flisadam/RFID_system/README.md

# RFID_system
This is simple RFID system for behaviour experiments with caged animals. The efuipment developed within this project is part of EcoHab cage.
More information about this cage is published here: https://elifesciences.org/articles/19532
