flisadam/RFID_system/Master.pdf

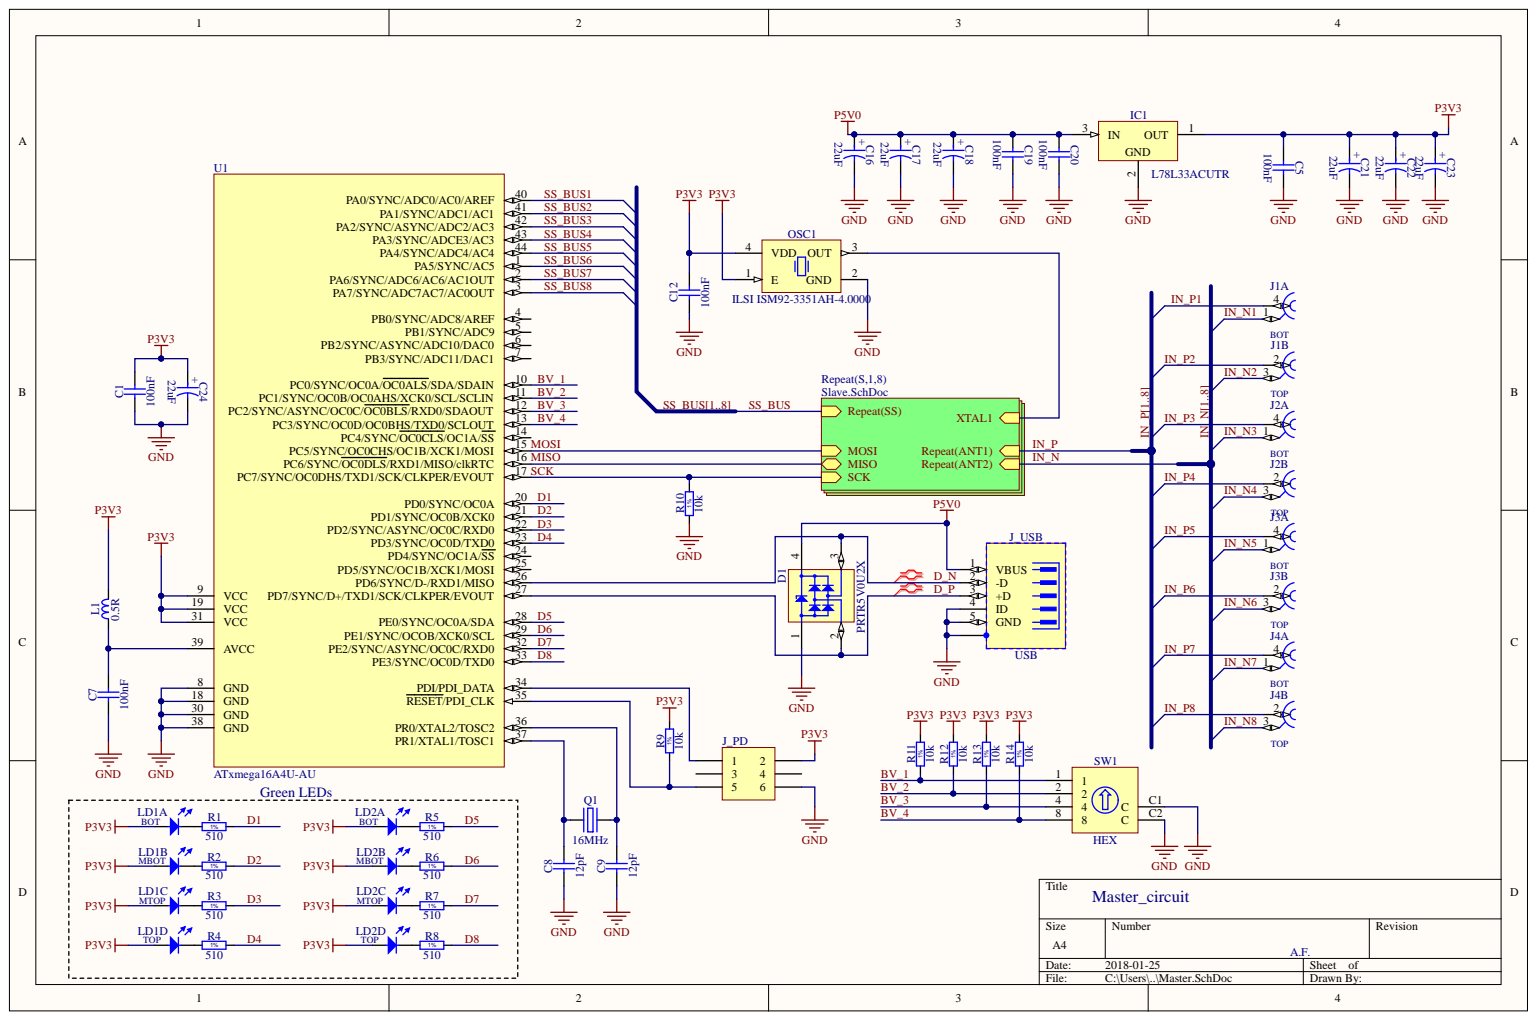
[picture p1: page 1]

GND 18 | P3V3

GND 38

# Board S
