flisadam/RFID_system/RFID_PCB.pdf

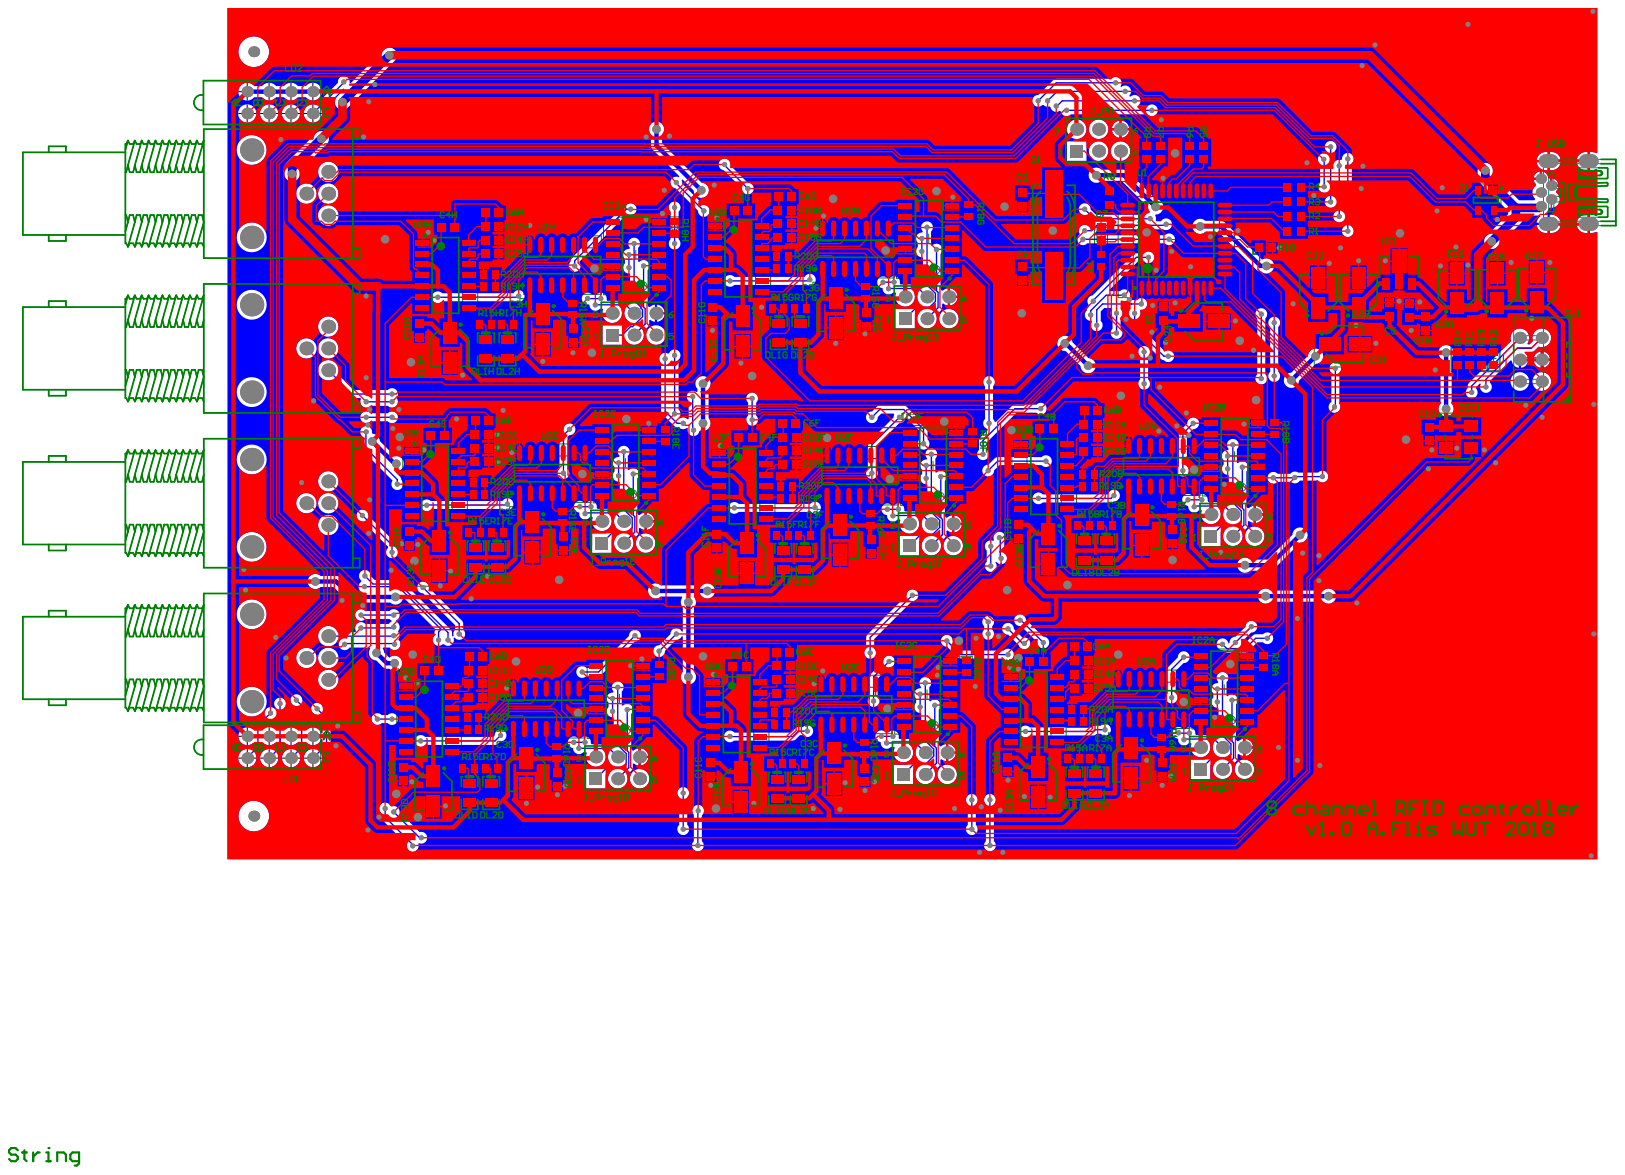
[picture p2: page 1]
