flisadam/RFID_system/Slave.pdf

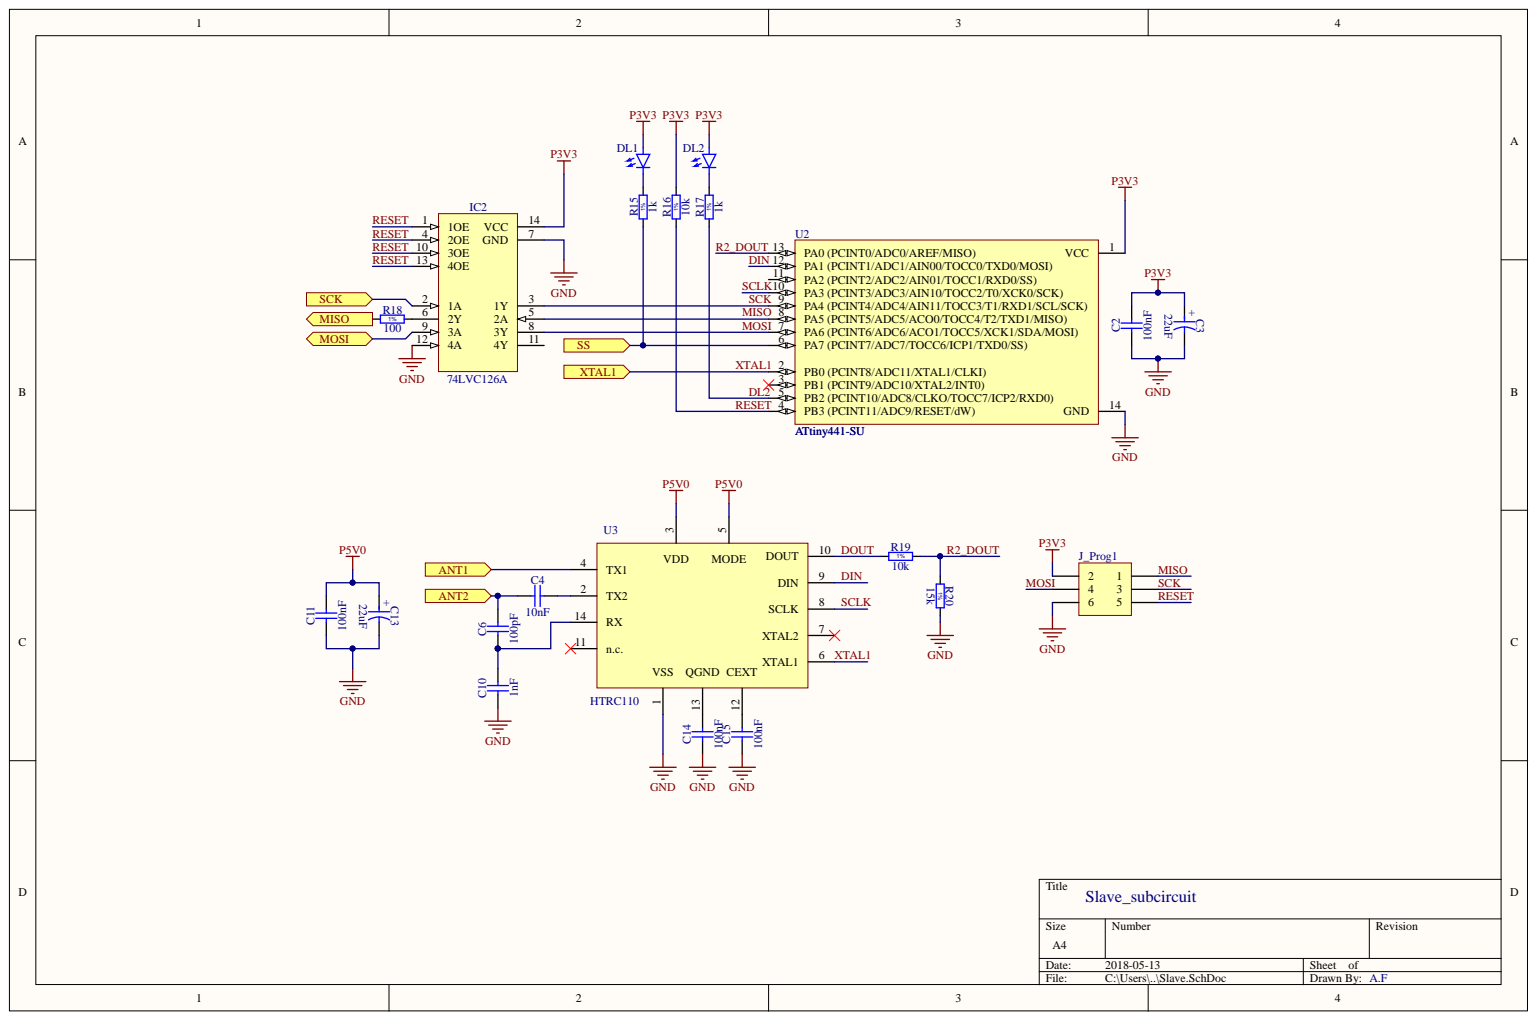
[picture p3: page 1]
