flisadam/RFID_system/Slave2.pdf

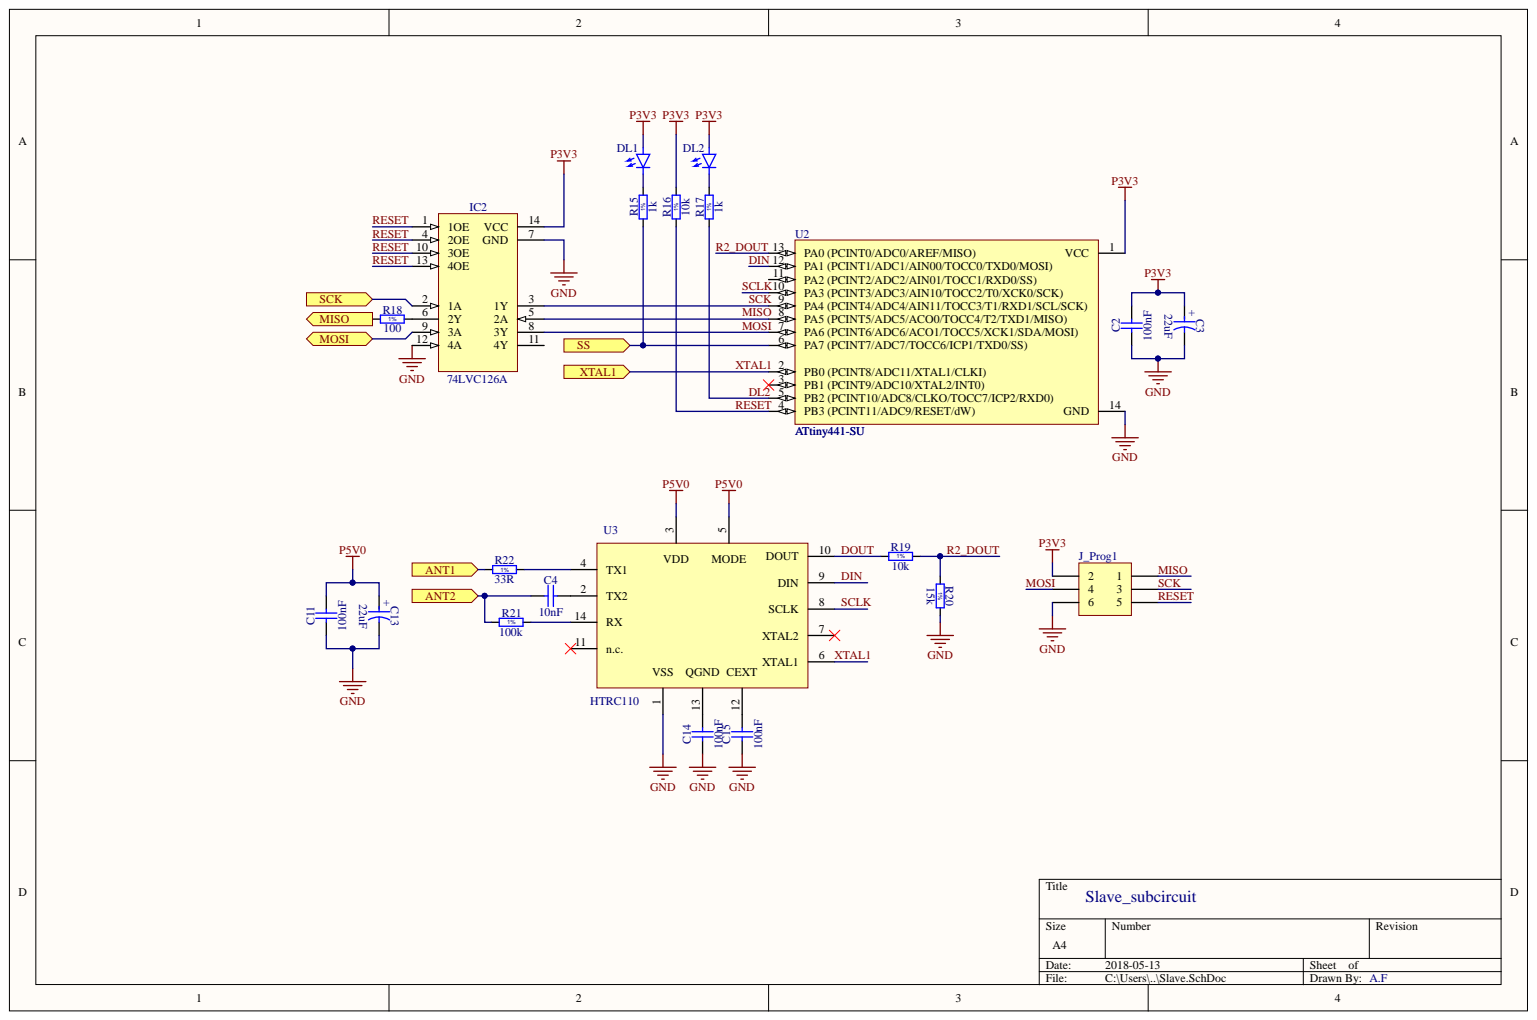
[picture p4: page 1]
