flisadam/RFID_system/Slave_new.pdf

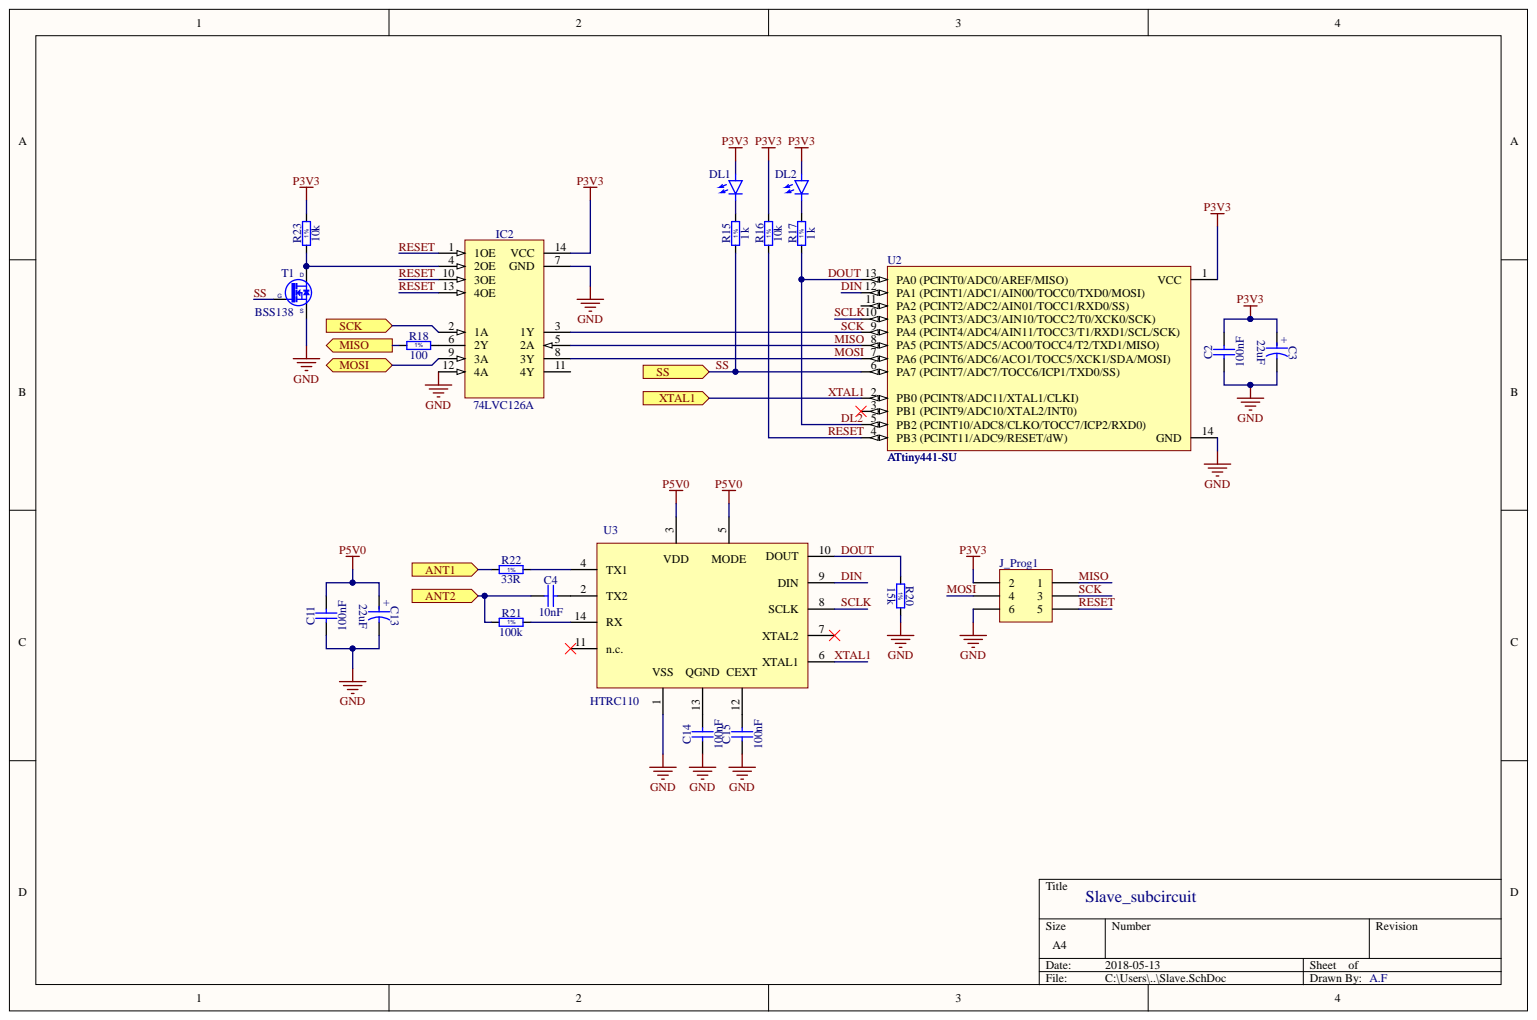
[picture p5: page 1]
