flisadam/RFID_system/(list of files, drawings)

Other design files:
Master.SchDoc
RFID_PCB.PcbDoc
RFID_system.PrjPcb
Slave.SchDoc
