flisadam/RFID_system/(threads)

Thread 2 (2017-11-21):

schematic review

gkasprow, 2017-11-21:
- [x] please remove all project -specific libraries. Install them as global. Now when I open the project it complains about missing libs.
- [x] add differential pair directive Place->Directie -> diff pairs
- [x] what is the role of P1 connector? Why there is same designator for both connectors?
- [x] don't use regular L with ceramic capacitor as filter. Use ferrite bead instead, otherwise it will oscillate.
- [x] fix this
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
- [x] there is serious error in USB connector grounding. Check it with application note. TVS GND should go to circuit GND!
- [x] RFID receivers must be synchronized together to not interfere with other channels. All RFID coils must have the same phase and frequency. Individual crystals don't provide such functionality.
- [x] SS line is not connected to the sheet entry

flisadam, 2017-11-22:
1.  I removed libraries. It should not complains now.
2. I added diff pair to USB D+ D- data.
3. I intented to use P1 as a switch on-off each CPU-slave and master with jumpers.
5.  I changed it. Hope it is more readable now.
6. I took connection of TVS to USB from that manual :
Atmel AVR1017: XMEGA - USB Hardware
Design Recommendations page 8
http://www.atmel.com/images/doc8388.pdf
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

7. Still to do.
8. I get a little bit confused about this. When i compile only Master.SchDoc- the message window returns error's of only one pin's connection
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
On the other hand when I compile hole project- there are none errors-just warnings about multiply name nets:
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
Finally when i check connection on the pcb everythink looks fine- I can connect with autoRoute each Slave SS pin in SS_bus with Xmega pins and also antenna bus
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

gkasprow, 2017-11-22:
6. Such USB TVS protection makes sense if you have metal enclosure with metallic panel that is connected with PE terminal. In such cases the ESD current flows to the chassis. We supply it from USB so these components are not needed and GND can be shorted with USB connector.
8. OK, it is fine, in my case for some reason Alt+click does not work.

In case of synchronization, you'd better visit biologists lab and see how it is done on prototype. It simply works and I don't remember how I did it :)

flisadam, 2017-11-23:
I changed the TVS connection-USB shield is shorted with GND TVS GND is also connected to GND.
I also add ferrite bead instead of L (I could not find any of them in Cern lib- I changed description of element and added footprint 0603 from other component)
https://www.tme.eu/gb/details/blm18he152sn1d/ferrite-beads/murata/

About the case of synchronization, could You send me via mail information with adress and person I can contact to visit biologist lab and see your prototype?

flisadam, 2017-12-12:
It seems that all of problem's in this issue were solved. Anyway, Could You verify the last version?

Closed 2017-12-27.

Thread 3 (2017-12-06):

RFID reader with autheitification

gkasprow, 2017-12-06:
It seem we have to change the reader chip.
HTRC110 has synchronisation and was used in original experiment.
It reads animal tags

gkasprow, 2017-12-06:
to synchronize the ICs simply connect them as on the photo
https://drive.google.com/file/d/11MaUKYV9UiBc9bnIUfT4B7IjpPNTmtSM/view

flisadam, 2017-12-10:
I have some questions about synchronizing

1.  Do I need to connect only pin  XTAL1 first one with XTAL2 second one and XTAL 2 second one with XTAL1 first one?

2. This synchronization concerns only the pair of ICs? So now I have 4 pairs, in which ICs are synchronised or do I have to connect 8 ICs with each other?

3. According to datasheet the pin MODE can active digital filter on DIN line - do we need it ?

4. This modules requires 2-way communication with ATtiny.  In my solution ATtiny is powered with 3V3 and HTRC110 with 5V. So in case of  communication on lines DIN, SCK and DOUT do i need to use converation of logic states (5V0->3V3; 3V3->5V)?

gkasprow, 2017-12-10:
> I have some questions about synchronizing
>
> 1.  Do I need to connect only pin  XTAL1 first one with XTAL2 second one and XTAL 2 second one with XTAL1 first one?
no, just give common clock oscillator and connect to all inputs
>
> 2. This synchronization concerns only the pair of ICs? So now I have 4 pairs, in which ICs are synchronised or do I have to connect 8 ICs with each other?
they all need to be kept in sync

>
> 3. According to datasheet the pin MODE can active digital filter on DIN line - do we need it ?
I'd provide such option

> 4. This modules requires 2-way communication with ATtiny.  In my solution ATtiny is powered with 3V3 and HTRC110 with 5V. So in case of  communication on lines DIN, SCK and DOUT do i need to use converation of logic states (5V0->3V3; 3V3->5V)?

What are logic levels? Is 3.3V logic H of HTRC chip? 5V->3.3V translation is simple and resistive divider does the job for such frequency
>
>
>

flisadam, 2017-12-10:
I have commited updated scheamtics with new RFID reader. Could You verify it?

I have also question if we can also use only one oscillator directly(or maybe through some bufor) to timing all Attiny's?
8 separate clock's does not seem to be much optimalized
I have never done system with several CPU's, so I'm not sure if it will work properly.

gkasprow, 2017-12-10:
Sure, that's the way to go. The same clock signal can drive attiny and RFID chip.

flisadam, 2017-12-12:
I have added common clock for slaves and ICS.

gkasprow, 2017-12-13:
This won't work. Use single clock generator and distribute it to all clock inputs.
Crystal oscillator will work only with single input and single output.
In current project version multiple outputs are connected together!!!

gkasprow, 2017-12-13:
- [ ] Please get rid of P1. This adds inductance to the supply nets. Take into account that AVCC is supplied continuously.
- [ ] missing SCK pulldown
- [ ] please make sure that you connected right SPI pins to the ISP connector. Different Atmega/ATtiny have different assignment. Some use RxD/TxD pins, some SPI pins.
- [ ] use right-angled LEDs and place them close to the side panels. For channel LEDs, place them close to the BNC connectors.

flisadam, 2017-12-13:
According to Attiny 441 datasheet pins need to programming is P4, P5 ,P6.
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

flisadam, 2017-12-27:
I added two front x4 Green Leds. Regarding to diodes which will be in side panels. I looked into 2x right angled diodes ( I have 2 diodes in each slave CPU) and most diodes cost about 7-8 zl. For 8-CPU's it will cost about 60zł  Use it anyway?

Link to the store
https://pl.mouser.com/ProductDetail/Dialight/553-0111-200F/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

gkasprow, 2018-01-04:
We need two SPI ports.
One master to read the HTRC110, one slave to give access to the main CPU.
But the Attiny has only one hardware SPI port
I assume that you want to read the RFID chip using software SPI

We don't need more than 1 LED per channel so 2x quad LED is fine.
The BNCs you used have shorten grounds of lower and upper connectors. It is not written in the datasheet but I have them in the lab.
So they cannot be used in such application.

Let's replace them with something more suitable.
There are ones with identical footprint, I use them in
https://github.com/m-labs/sinara/tree/master/ARTIQ_ALTIUM/EEMs/Sampler
Just take this design and copy footprint and schematic symbols.

flisadam, 2018-01-11:
I changed BNC's.
I left 2x quad led on the front panel, but i would like to left 1-2 diodes to each slave CPU. It will help me with programming

gkasprow, 2018-01-11:
OK, go on with layout.

Closed 2018-01-14.

Thread 4 (2017-12-19):

add address switch

gkasprow, 2017-12-19:
please add hex or decimal address switch available on the front or rear panel.
We want to use multiple boxes in the experiment and want to identify them.
So the device will transfer a frame that consists of:
- switch position - box number
- coil ID
- RFID tag number

flisadam, 2017-12-27:
I added hex rotary switch to rear side of PCB board

Closed 2018-01-07.

Thread 5 (2018-01-11):

PCB layout and routing

flisadam, 2018-01-11:
I have do peliminary placement of components and routing in slave circuits. Before I proceed to master circuiut and connection beetwen master-slave, I wanted to know if you have some comments. Could you look at it?

Strings S1-S8 are temporary, just for me to easier look at PCB.
I will  correct some tracks to connect pads at 90 degree in next commit.

gkasprow, 2018-01-11:
go on with routing.
Use mainly top layer, bottom will be solid ground plane. Max 1cm traces are allowed there.
use 0.3/0.6 vias for regular traces, 0.8/0.6 vias for power traces, >6 mils traces and 6 mils clearace for regular tracks, >20 mils for power traces.

flisadam, 2018-01-13:
I just commited last changes. I route all tracks, but honestly it could be done much better.  I think there are to much vias and top layer routes.  Could you look also on diff USB pair tracks? Becouse of usb footprint i could not place them closer, so i make longer   D_P trace to equals impednaces. Was it neccesery?
How do you think? Can I put ground polygon and make GND connection or try again to route it better?

gkasprow, 2018-01-14:
As I wrote, don't use that long traces on bottom side. It must be solid plane!
There is plenty of space on top side. Vias do not cost any money.
for this speed U don't need to equalize USB traces
here is example of 2-layer routing.
please note:
- vias at the board edge
- max trace length at the ground plane
- 15mils distance between polygon and traces
- pieces of GND polygon connected with solid GND polygon using vias

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

flisadam, 2018-01-15:
I commited PCB with corrected bottom traces-all of them are shorter than 1cm now. If you have a while, you can look at it. In meantime I will make same cosmetic changes and add GND polygon

flisadam, 2018-01-15:
I uploaded full PCB layout. Do you have any suggestions or comments ?

gkasprow, 2018-01-17:
that's OK,
I fixed some minor issues and will ship it to the assembly house.

Closed 2018-01-17.

Thread 6 (2018-01-22):

Voltage regulator consider to change

flisadam, 2018-01-22:
I looked again into schematic and looked into our volatage regulator. It appears that i skipped SMD LED current into current balance.  When I done it again and use all maximum ratings for all 3V3 supplied devices it exceeded maximum current output.

device | typ | max |
-------|-----|-------------
HTRC1100 | 4mA | 10mA
ATXmega16A4U(32MHz 3V)	 | 1.25mA| 2mA
Attiny441(3V 4MHz)		|        1.25mA	|2mA
Ceramic generator(3V3)	|	-   |             40mA
BIVAR LED (3.3V)		|   - | 2.3mA
SMD LED x16                   |  -| 1.4mA

Devices that uses 3V3 supply | current
-------|-
Attiny 	x8 	|	16mA
ATxmega x1	|	12mA
Bivar LED x8	 |       18.4mA
Ceramic generator|	40mA
SMD LED x16 	     |   22.4mA
Sum |  108.8mA

L78L33ACUTR maximum curreent output- 0.1 A
[L78L33ACUTR ](https://www.tme.eu/pl/Document/b7b31075f2d58667ecc8d5791659471f/L78L_1.pdf )
page 5-6
I know that generator won't uses 40mA at 4 MHz and all diodes won't be used at same time.
But second issue is fact that L78L33ACUTR has 2V dropout. So it will gives  3V instead of 3V3.

I found another regulator in the same package (SOT89) - TS9011SCY- so i can solder it instead.
[TS9011SCY](https://www.tme.eu/pl/Document/7b1ffa4b45baaa75f09d78973c92f55b/TS9011-DTE.pdf)
It has 0.25A max output current and lower dropout so we will be sure to get 3V3.
So if there will be some problems with supply it can be consider to replace it.

Thread 7 (2018-02-08):

BOM

gkasprow, 2018-02-08:
L1 - missing PN
clarify PN and comment of 125 buffer (IC2)

flisadam, 2018-02-13:
I added Part number do L1 and changed parameters  of buffer- it should be  74LVC126A buffer

Closed 2018-02-27.
