flisadam/RFID_system/(commit log)

2017-10-10 schematic #1
    [RFID_system.PrjPcb, RFID_system.SchDoc, RFID_system_2.SCHLIB, Schlib1.SchLib, Sheet1.SchDoc, Sheet2.SchDoc]
2017-10-16 Schematic done
    [RFID_system.PrjPcb, Sheet1.SchDoc, Sheet2.SchDoc]
2017-10-30 Atxmega changed- added subcircuit converter
    [Converter.SchDoc, RFID_PCB.PcbDoc, RFID_system.PrjPcb, RFID_system.SCHLIB, RFID_system.SchDoc, RFID_system_atxmegau.SCHLIB, Sheet1.SchDoc, Sheet2.SchDoc]
2017-11-11 PCB 4x Slave inserted
    [Converter.SchDoc, RFID_PCB.PcbDoc, RFID_system.PrjPcb, RFID_system_1.SCHLIB, Sheet1.SchDoc, Sheet2.SchDoc]
2017-11-13 Preliminary arrangement of elements
    [Converter.SchDoc, Master.SchDoc, RFID_PCB.PcbDoc, RFID_system.PrjPcb, Sheet1.SchDoc, Sheet2.SchDoc, Slave.SchDoc]
2017-11-21 Antenna connectors changed, TVS security added
    [Master.SchDoc, RFID_PCB.PcbDoc, RFID_system.PrjPcb, Slave.SchDoc]
2017-11-21 Crysal oscillator changed, added pull up to XMega reset
    [Master.SchDoc, RFID_PCB.PcbDoc]
2017-11-22 libs removed
    [Master.SchDoc, RFID_system.PrjPcb, Slave.SchDoc]
2017-11-22 Diffpair added
    [Master.SchDoc]
2017-11-23 TVS connection corrected, added ferrite bead
    [Master.SchDoc, RFID_PCB.PcbDoc, RFID_system.PrjPcb, Slave.SchDoc]
2017-12-10 RFID reader changed to HTRC110
    [Master.SchDoc, Slave.SchDoc]
2017-12-12 Common clock for ICs
    [Master.SchDoc, Slave.SchDoc]
2017-12-13 Clock generator added, SCK pulldown
    [Master.SchDoc, Slave.SchDoc]
2017-12-27 Added hex rotary switch and front panel LEDs
    [Master.SchDoc, RFID_PCB.PcbDoc, RFID_system.PrjPcb, Slave.SchDoc]
2017-12-27 Diodes resistors changed from 1k do 510 Ohms
    [Master.SchDoc]
2018-01-11 BNC's changed
    [Master.SchDoc, RFID_PCB.PcbDoc]
2018-01-11 Slave's circuit routing added, change placement of components
    [RFID_PCB.PcbDoc]
2018-01-12 Roouting improved,added power route
    [RFID_PCB.PcbDoc]
2018-01-12 Master routing
    [RFID_PCB.PcbDoc]
2018-01-13 All routing without GND
    [Master.SchDoc, RFID_PCB.PcbDoc]
2018-01-14 GND polygon
    [RFID_PCB.PcbDoc]
2018-01-15 Routes on top layer #1
    [RFID_PCB.PcbDoc]
2018-01-15 Routes on top leyer #2
    [RFID_PCB.PcbDoc]
2018-01-15 Routes on top layer #3
    [RFID_PCB.PcbDoc]
2018-01-15 Bottom routes fully corrected
    [RFID_PCB.PcbDoc]
2018-01-15 PCB full layout
2018-01-17 fixed several issues: - wrong ISP connector pinout - reduced BOM - cheaper hex switch - ERC and DRC errors
    [Master.SchDoc, RFID_system.PrjPcb, Slave.SchDoc]
2018-02-13 L1 and IC2 specified
    [Master.SchDoc, RFID_system.PrjPcb, Slave.SchDoc]
2018-08-10 zmiany 1
    [RFID_system.PrjPcb]
2018-08-10 actual schematic
    [RFID_system.PrjPcb]
